diysco2/sensor/CHB-assembly.md

# Custom Hardware Board Assembly

1. Mount DC/DC power supply (PXE30-12S12)
2. Once soldered on the board, cut its pins (otherwise they'll touch Mega's ICSP header).
3. Install 4-pin RS232 connector (header)
4. Install top two Sockets for GPS Shield:

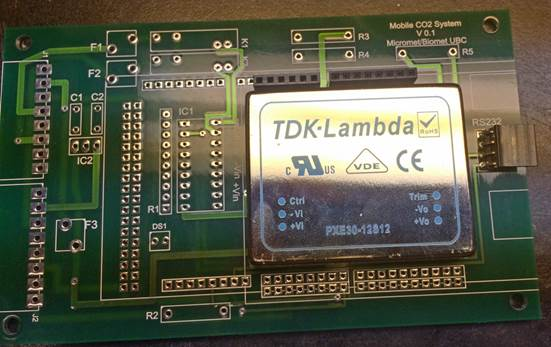
[picture p2: img/chb-001.jpg]
	

5. Install the top 3 8-pin headers for Arduino Mega (all headers are bottom facing!!)

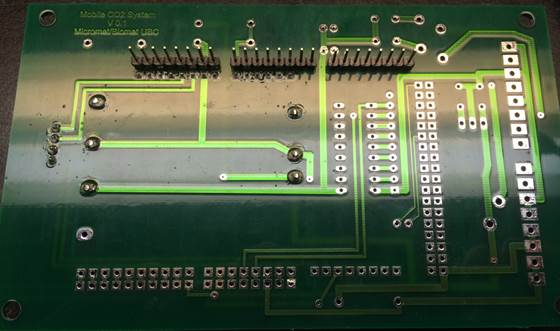
[picture p3: img/chb-002.jpg]
	

	

6. Install Relay driver socket and the resistor network (otherwise with all sockets and headers installed there will be no access for the soldering iron)

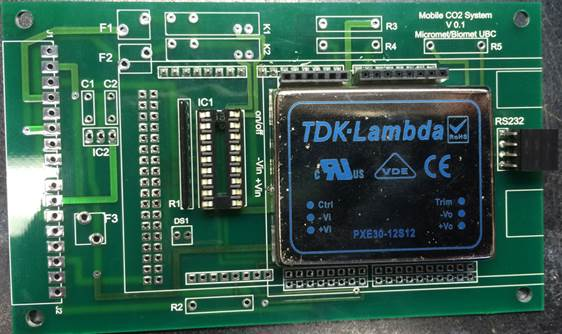
[picture p4: img/chb-004.jpg]
	

7. Install the diode (DS1).  Flat part goes towards the DC/DC power supply (TDK-Lamda)
8. Cut the diode pins
9.  Install all ONE-ROW headers into the Arduino Mega (just push the pins into the Mega's sockets).
10.  Install the Mega into the shield and solder the pins

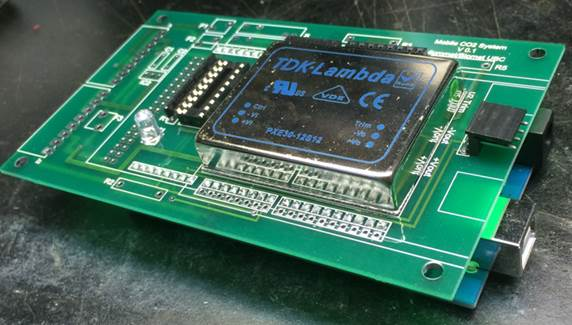
[picture p5: img/chb-005.jpg]
	

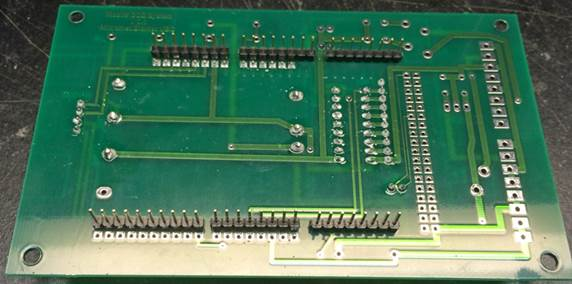
[picture p6: img/chb-006.jpg]
	

11.  Put the sockets into the GPS board (just push them in onto the headers).
12.  Mount the GPS board over the DC/DC power supply.  In the pictures below, the GPS unit has 2 upward facing headers on the bottom of the board.  Those are not needed for the system operation (they were left over from a previous prototype.)
13.  Solder the bottom set of pins (the newly installed sockets)

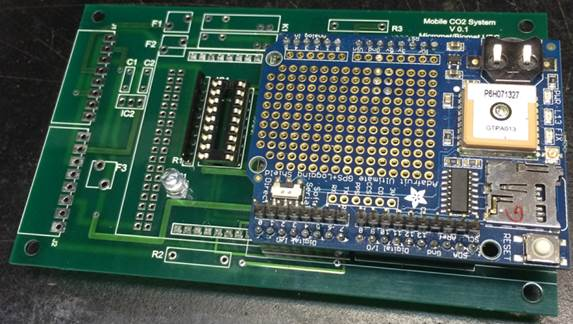
[picture p7: img/chb-007.jpg]
	

14. At this stage the GPS board is fully mounted.  Remove it.
15. This is what how the board looks so far:

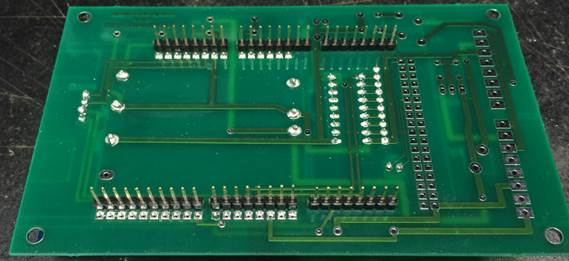
[picture p8: img/chb-008.jpg]
	

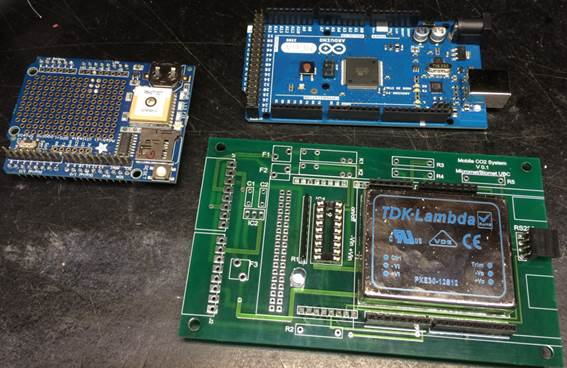
[picture p9: img/chb-009.jpg]
	

16. Bend 4 resistors (2 x 10k, 2 x 5k) at 0.5" mark and solder them on the board:

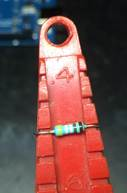
[picture p10: img/chb-010.jpg]
	

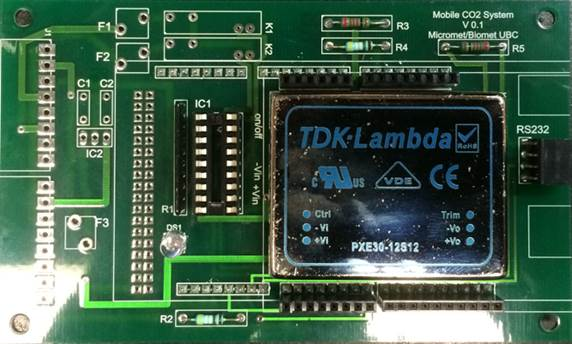
[picture p11: img/chb-011.jpg]
	

17. Cut resistor pins.
18. Install and solder two top fuses with their openings (holes) facing to the left.

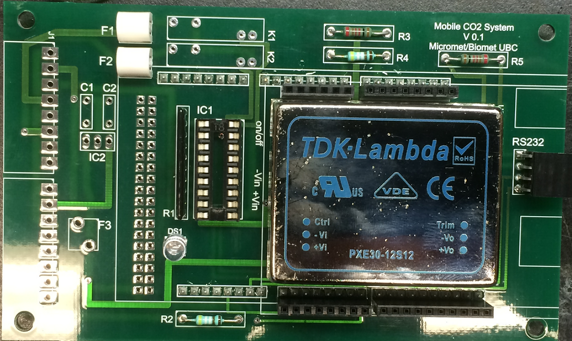
[picture p12: img/chb-012.png]
	

19. Install the two relays.

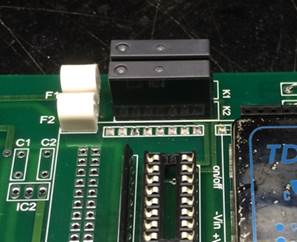
[picture p13: img/chb-013.jpg]
	

20. Insert 2-row header into the Mega and put the Mega onto the board.
21. Solder 2-row header

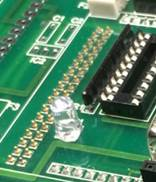
[picture p14: img/chb-014.jpg]
	

22. Solder two capacitors.
23. Cut the pins

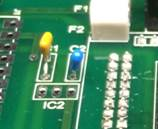
[picture p15: img/chb-015.jpg]
	

24. Solder 7805
25. Cut the pins
26. Solder the last fuse holder (holes facing "down")

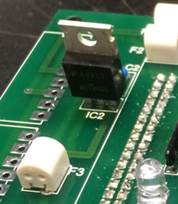
[picture p16: img/chb-016.jpg]
	

27. Solder the two 8-position black connectors

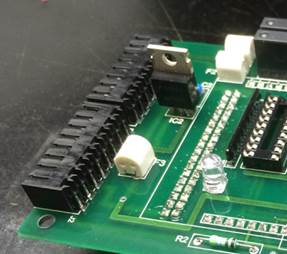
[picture p17: img/chb-017.jpg]
	

28. Inspect
29. Mount UNL2803A

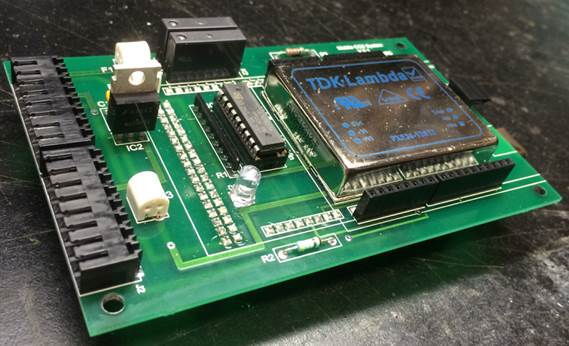
[picture p18: img/chb-018.jpg]
	

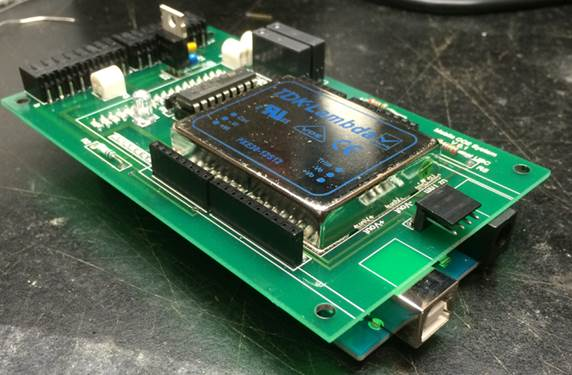
[picture p19: img/chb-019.jpg]
	

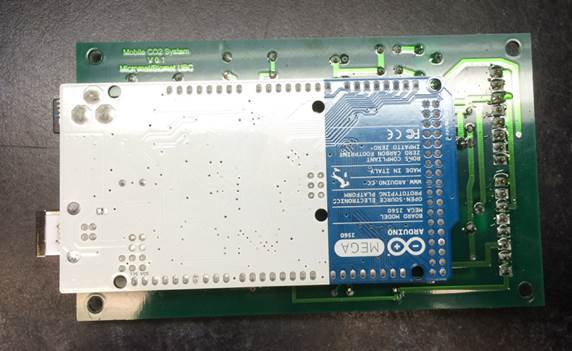
[picture p20: img/chb-020.jpg]
	

33. Mount GPS

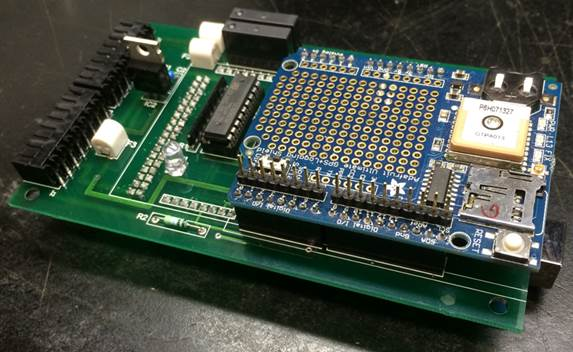
[picture p21: img/chb-021.jpg]
	

34. Populate Fuses

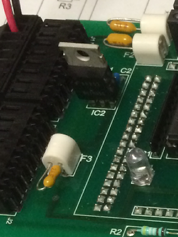
[picture p22: img/chb-022.png]
	

35. Finally look at the board without Arduino Mega and GPS

	

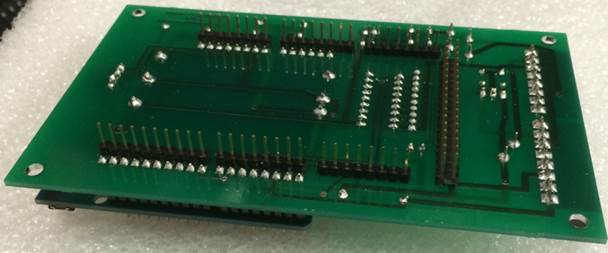
[picture p23: img/chb-024.jpg]
