diysco2/sensor/Assembly/Board manufacturing.pdf

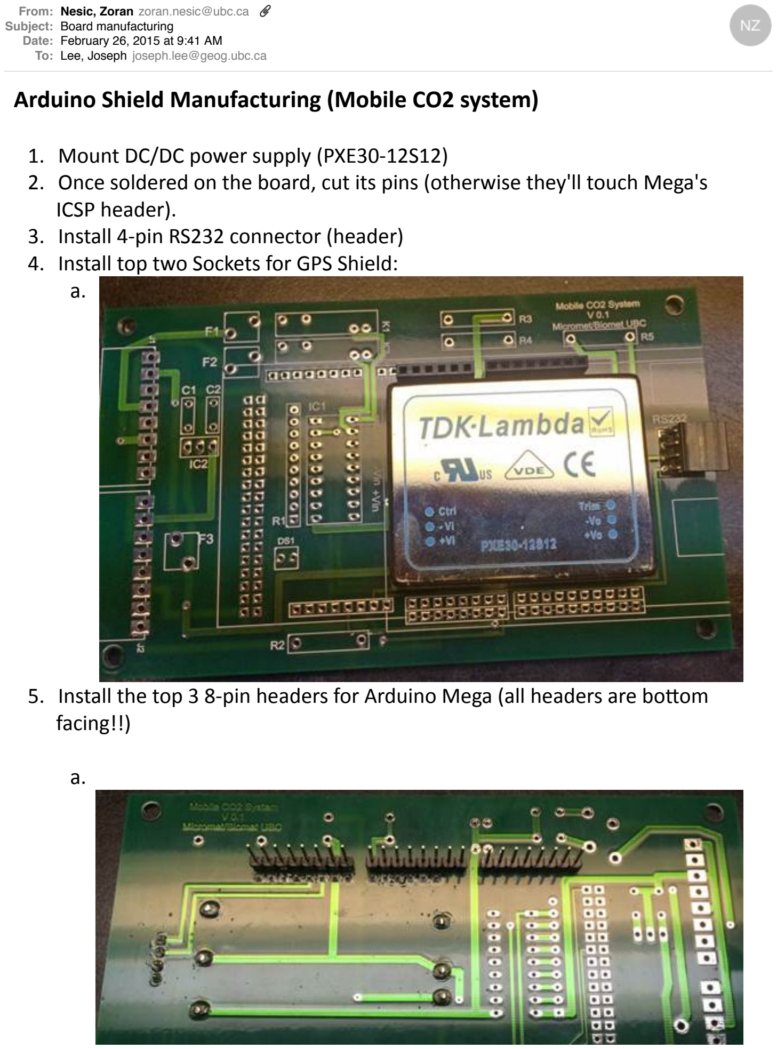
[picture p24: page 1]

From: Nesic, Zoran zoran.nesic@ubc.ca Subject: Board manufacturing
Date: February 26, 2015 at 9:41 AM
To: Lee, Joseph joseph.lee@geog.ubc.ca
Arduino(Shield(Manufacturing((Mobile(CO2(system)
1. Mount!DC/DC!power!supply!(PXE30912S12)
2. Once!soldered!on!the!board,!cut!its!pins!(otherwise!they'll!touch!Mega's ICSP!header).
3. Install!49pin!RS232!connector!(header)
4. Install!top!two!Sockets!for!GPS!Shield:
a.
5. Install!the!top!3!89pin!headers!for!Arduino!Mega!(all!headers!are!boQom facing!!)

a.

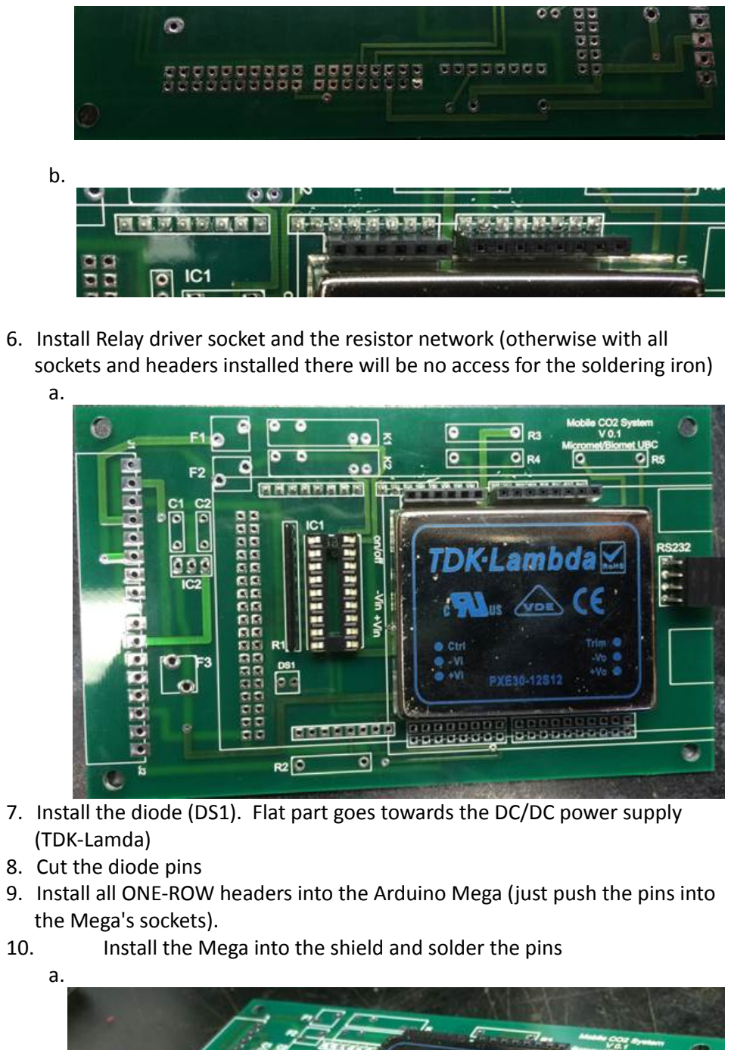
[picture p25: page 2]

b.

6. Install!Relay!driver!socket!and!the!resistor!network!(otherwise!with!all sockets!and!headers!installed!there!will!be!no!access!for!the!soldering!iron) a.
7. Install!the!diode!(DS1).!!Flat!part!goes!towards!the!DC/DC!power!supply (TDK9Lamda)
8. Cut!the!diode!pins
9. Install!all!ONE9ROW!headers!into!the!Arduino!Mega!(just!push!the!pins!into the!Mega's!sockets).
10. Install!the!Mega!into!the!shield!and!solder!the!pins
a.

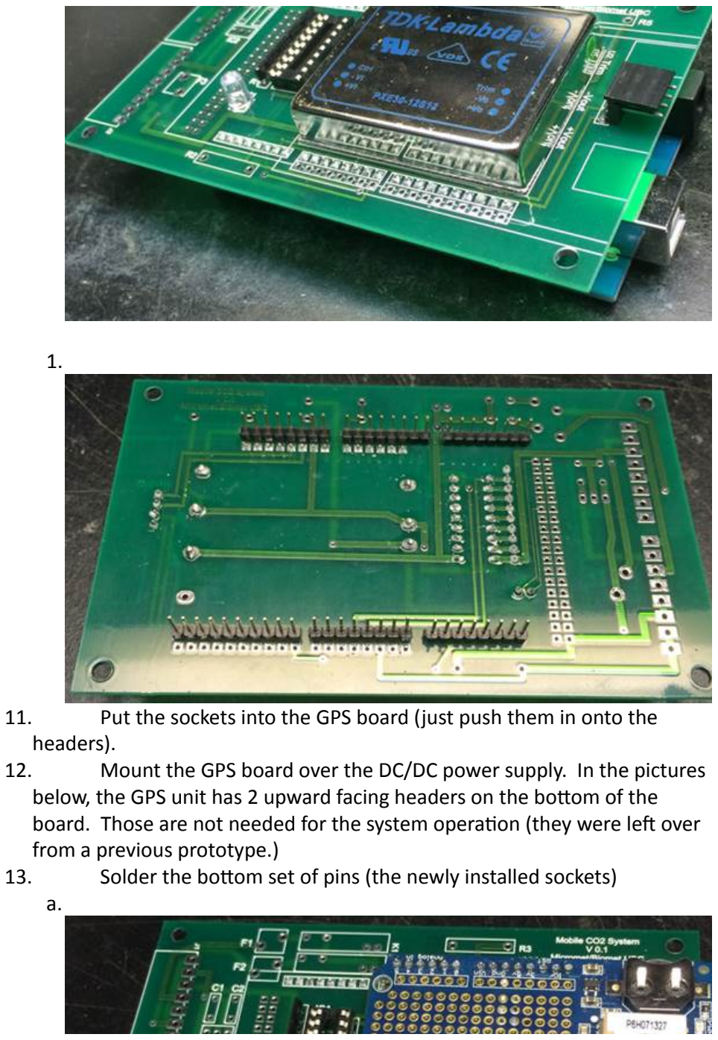
[picture p26: page 3]

1.

11. Put!the!sockets!into!the!GPS!board!(just!push!them!in!onto!the headers).
12. Mount!the!GPS!board!over!the!DC/DC!power!supply.!!In!the!pictures below,!the!GPS!unit!has!2!upward!facing!headers!on!the!boQom!of!the board.!!Those!are!not!needed!for!the!system!opera_on!(they!were!le`!over from!a!previous!prototype.)
13. Solder!the!boQom!set!of!pins!(the!newly!installed!sockets)
a.

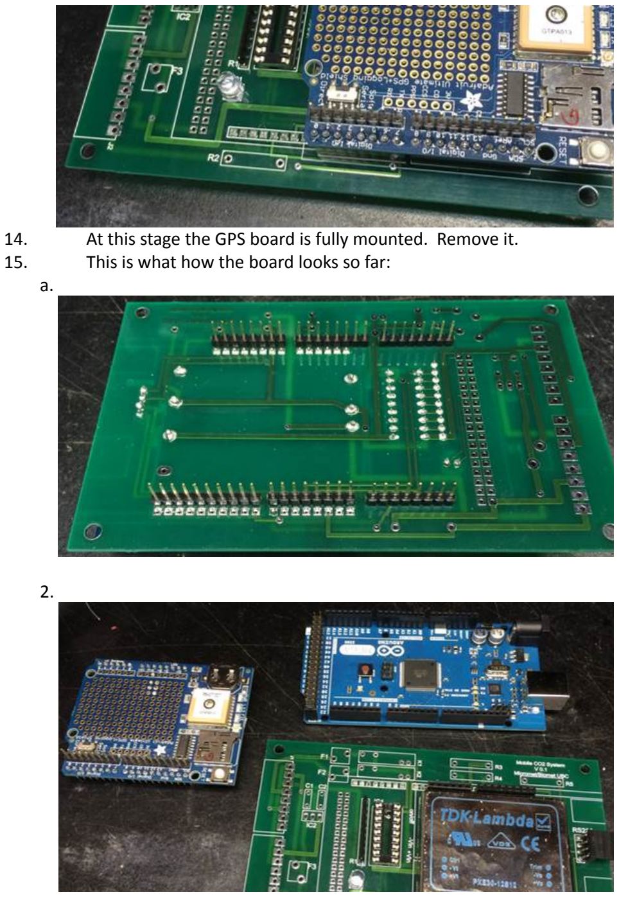
[picture p27: page 4]

14. At!this!stage!the!GPS!board!is!fully!mounted.!!Remove!it.
15. This!is!what!how!the!board!looks!so!far:
a.

2.

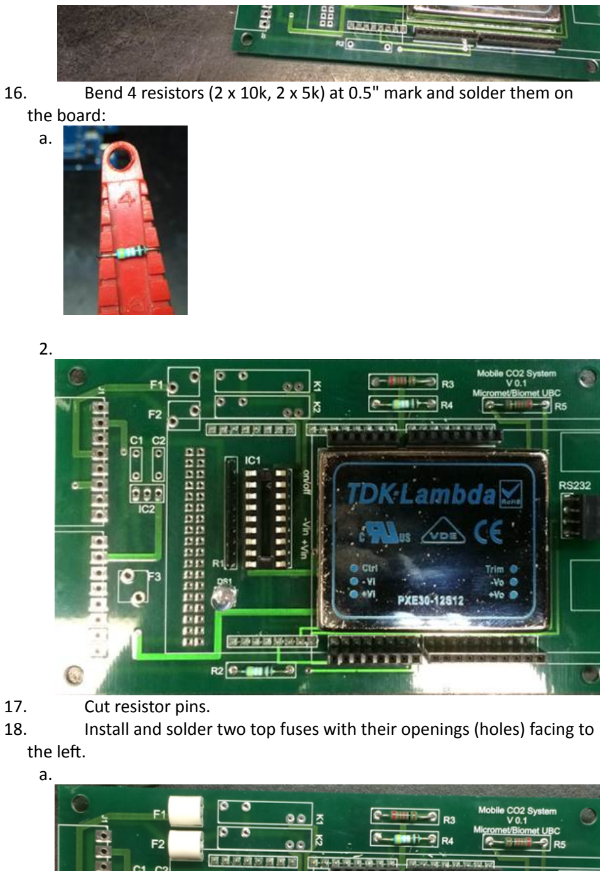
[picture p28: page 5]

16. Bend!4!resistors!(2!x!10k,!2!x!5k)!at!0.5"!mark!and!solder!them!on the!board:
a.

2.

17. Cut!resistor!pins.
18. Install!and!solder!two!top!fuses!with!their!openings!(holes)!facing!to the!le`.
a.

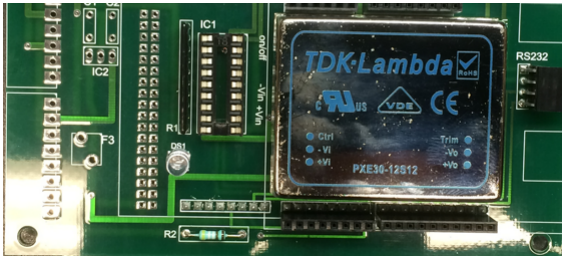
[picture p29: figure]

19. Install!the!two!relays. a.


20. Insert!29row!header!into!the!Mega!and!put!the!Mega!onto!the board.
21. Solder!29row!header
a.


22. Solder!two!capacitors.
23. Cut!the!pins
a.

24. Solder!7805
25. Cut!the!pins
26. Solder!the!last!fuse!holder!(holes!facing!"down") a.


27. Solder!the!two!89posi_on!black!connectors a.


28. Inspect
29. Mount!UNL2803A
a.

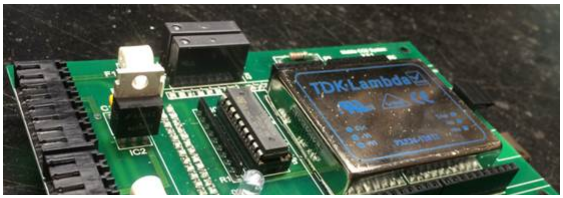
[picture p30: figure]
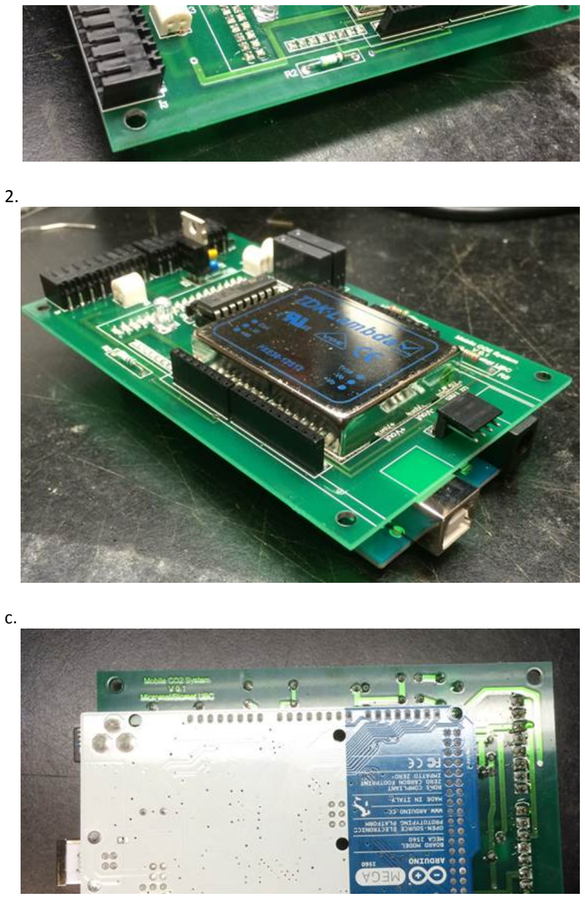
[picture p31: page 8]

2.

c.

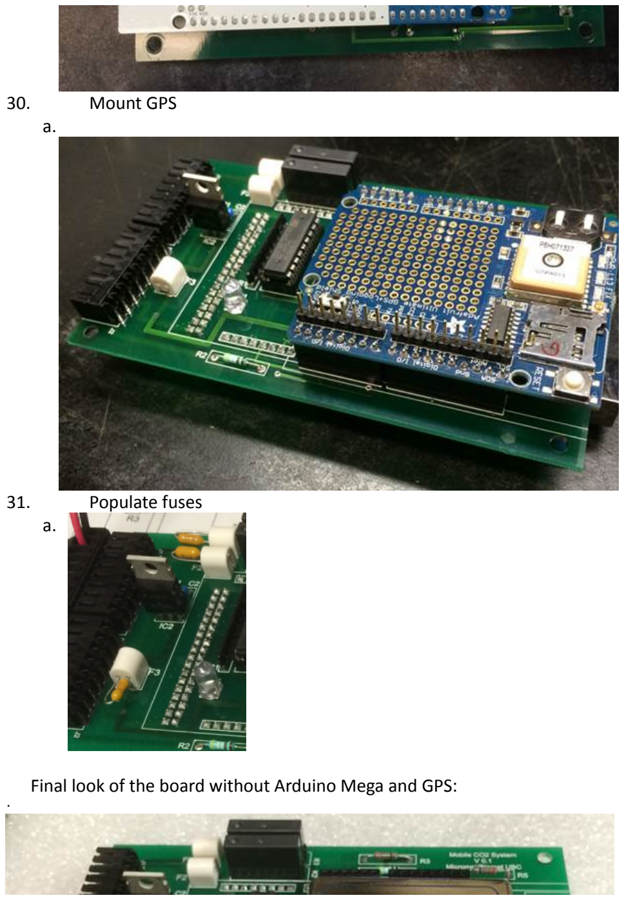
[picture p32: page 9]

30. Mount!GPS
a.
31. Populate!fuses
a.

Final!look!of!the!board!without!Arduino!Mega!and!GPS: ·

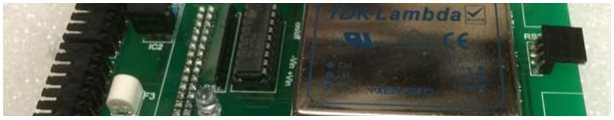
[picture p33: figure]
