diysco2/sensor/img/ARDUINO_RS232_cable.pdf

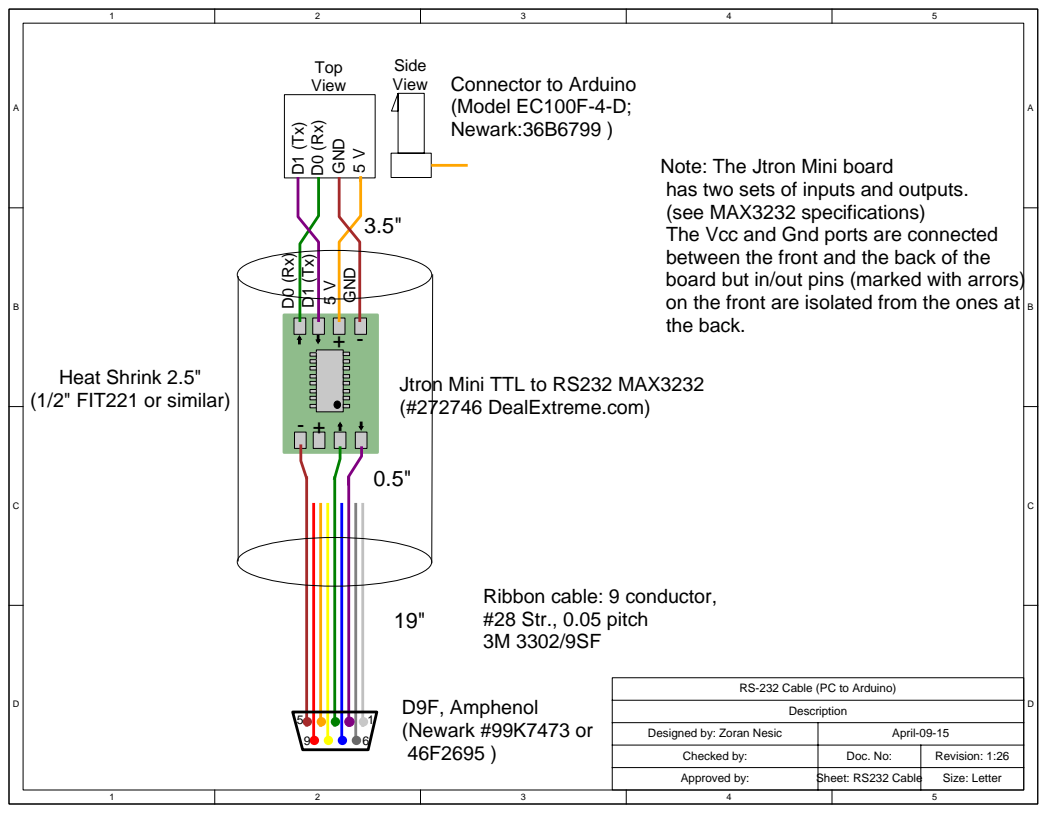
[picture p34: page 1]
Description; GND; D9F, Amphenol (Newark #99K7473 or 46F2695 ); Top View; View; Heat Shrink 2.5" (1/2" FIT221 or similar)

Side
Connector to Arduino
(Model EC100F-4-D;
Newark:36B6799 )

Note: The Jtron Mini board
has two sets of inputs and outputs.
(see MAX3232 specifications)
The Vcc and Gnd ports are connected
between the front and the back of the
board but in/out pins (marked with arrors)
on the front are isolated from the ones at
the back.

Jtron Mini TTL to RS232 MAX3232
(#272746 DealExtreme.com)

Ribbon cable: 9 conductor,
#28 Str., 0.05 pitch

RS-232 Cable (PC to Arduino)

Designed by: Zoran Nesic | April-09-15
Checked by: | Doc. No: | Revision: 1:26
Approved by: | Sheet: RS232 Cable | Size: Letter
