diysco2/sensor/(commit log)

2017-02-21 added li820 config howto
    [li820-diysco2-config.txt]
2017-02-21 added section for inlet tube system
2017-02-21 update sensor readme
2017-02-27 upload photos for custom hardware board
2017-02-27 added custom hardware board assembly instructions
2017-02-27 added image for arduino to rs232
